eccentricOrange/can-daq/docs/system-diagram/system-diagram-transparent.drawio.png

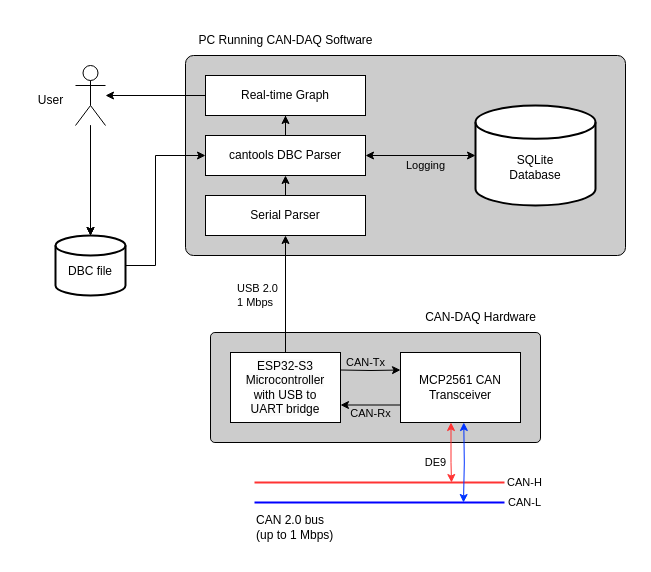
docs/system-diagram/system-diagram-transparent.drawio.png
