eccentricOrange/can-daq/can-daq-pcb/can-daq-pcb.kicad_pcb

## KiCad design can-daq-pcb/can-daq-pcb.kicad_pcb (2025-04-13)

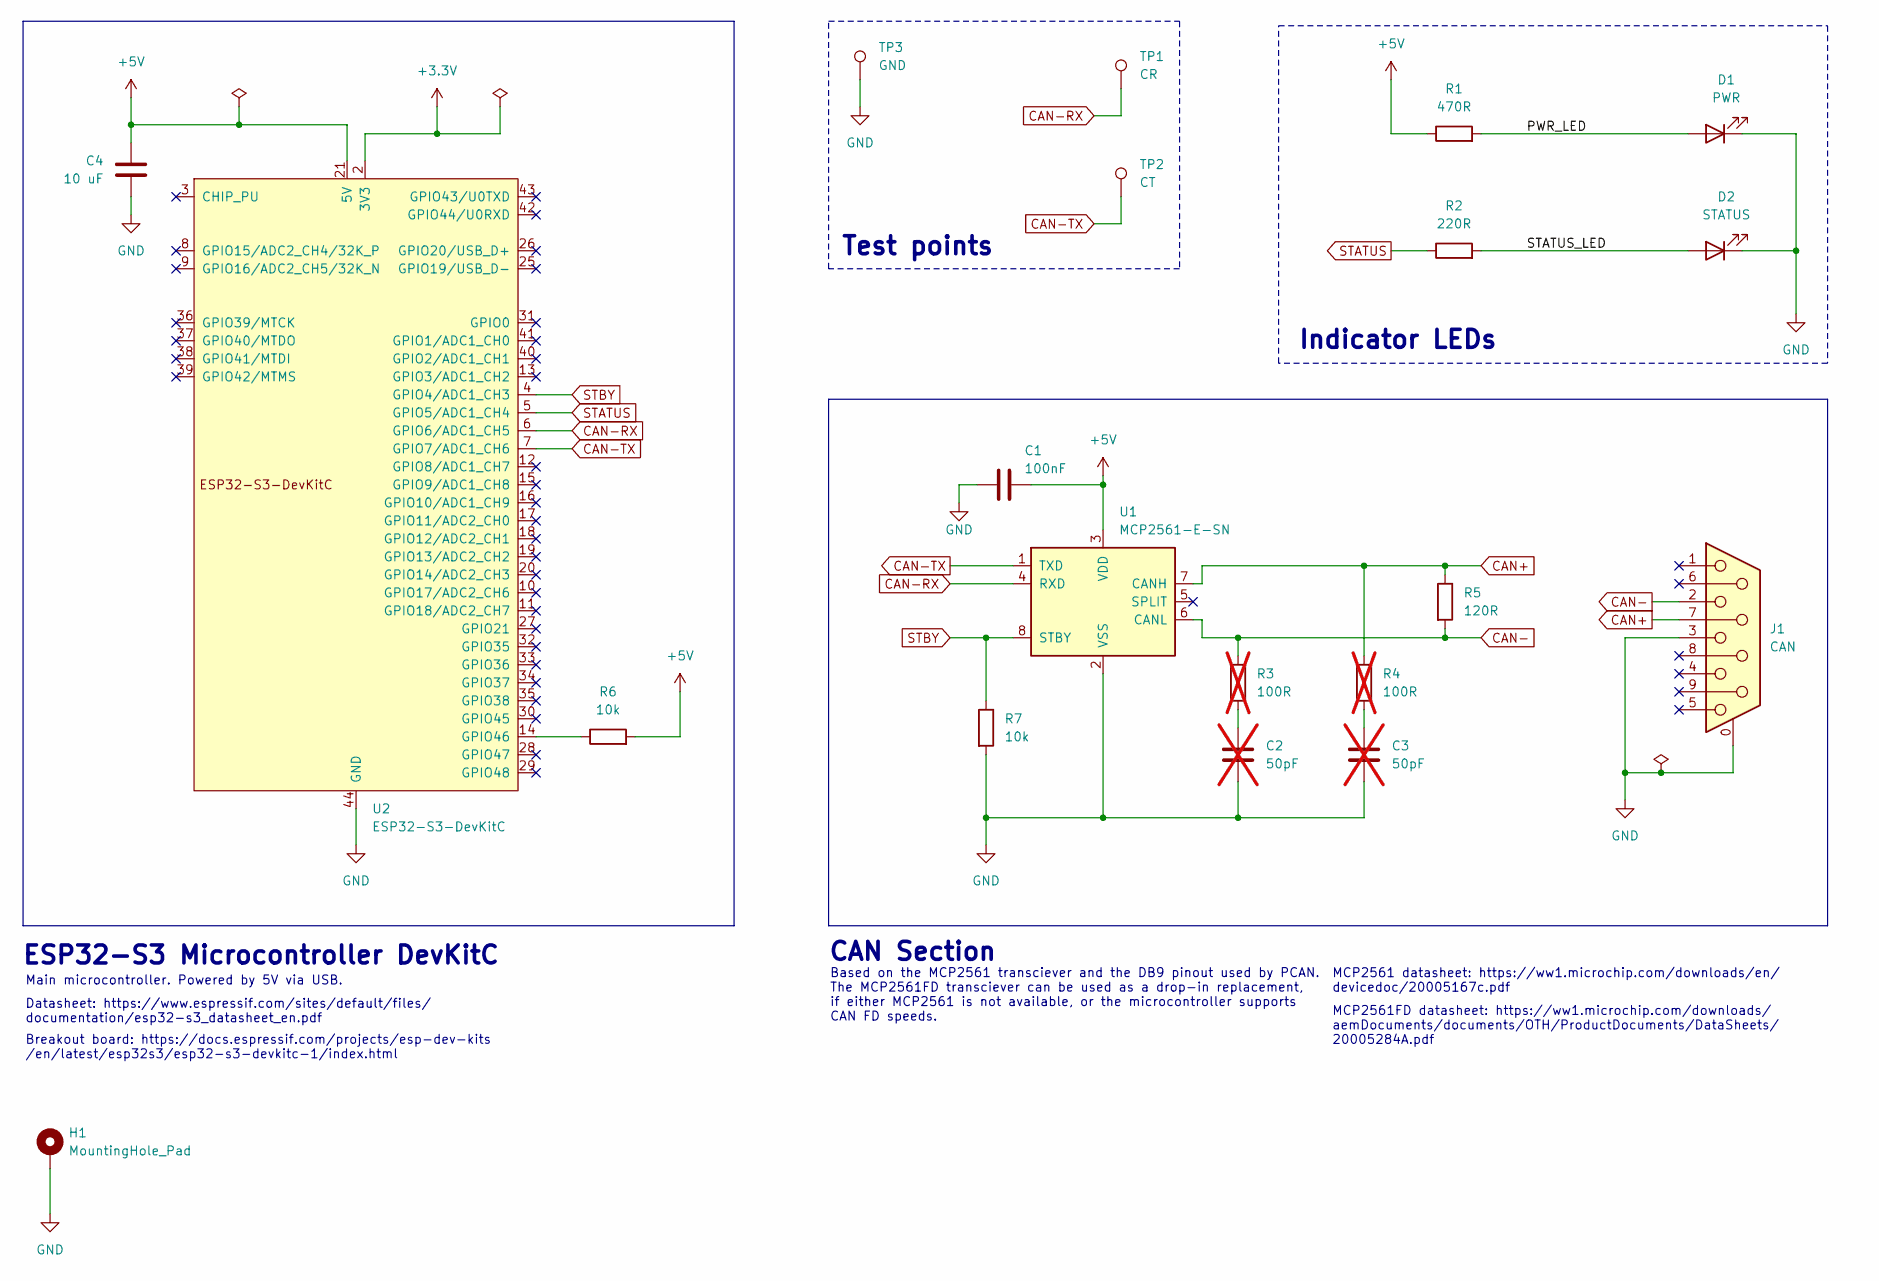
[picture p11: schematic can-daq-pcb.kicad_sch, CAN-DAQ PCB]

Parts:
C1: 100nF; C_0805_2012Metric_Pad1.18x1.45mm_HandSolder; MPN CC0805KRX7R9BB104; JLC C49678
C2, C3: 50pF; C_1206_3216Metric_Pad1.33x1.80mm_HandSolder; MPN FCC1206N470J102DT; JLC C5137553; not fitted
C4: 10 uF; C_1206_3216Metric_Pad1.33x1.80mm_HandSolder; MPN CL31A106KBHNNNE; JLC C13585
D1: PWR; LED_D3.0mm; MPN TZ-L2-03YYBR2RDJ30-003; JLC C779429
D2: STATUS; LED_D3.0mm; MPN TJ-L3FYTGCBMCGSFLC6B-A5; JLC C330760
H1: MountingHole_Pad; MountingHole_3.2mm_M3_Pad_Via
J1: CAN; DSUB-9_Female_Horizontal_P2.77x2.84mm_EdgePinOffset4.94mm_H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; MPN DS1037-09FNAKT74-0CC; JLC C75749
R1: 470R; R_1206_3216Metric_Pad1.30x1.75mm_HandSolder; MPN RC1206FR-07470RL; JLC C114945
R2: 220R; R_1206_3216Metric_Pad1.30x1.75mm_HandSolder; MPN 1206W4J0221T5E; JLC C25363
R3, R4: 100R; R_1206_3216Metric_Pad1.30x1.75mm_HandSolder; MPN 1206W4F1000T5E; JLC C17901; not fitted
R5: 120R; R_1206_3216Metric_Pad1.30x1.75mm_HandSolder; MPN 1206W4F1200T5E; JLC C17909
R6, R7: 10k; R_1206_3216Metric_Pad1.30x1.75mm_HandSolder; MPN 1206W4F1002T5E; JLC C17902
TP1: CR; TestPoint_THTPad_1.0x1.0mm_Drill0.5mm
TP2: CT; TestPoint_THTPad_1.0x1.0mm_Drill0.5mm
TP3: GND; TestPoint_THTPad_1.0x1.0mm_Drill0.5mm
U1: MCP2561-E-SN; SOIC-8_3.9x4.9mm_P1.27mm; MPN MCP2561-E/SN; JLC C219833
U2: ESP32-S3-DevKitC; MPN ESP32-S3-DEVKITC-1-N8; JLC C20438410

Connections:
+3.3V: U2.1 (3V3), U2.2 (3V3)
+5V: C1.1, C4.1, R1.1, R6.2, U1.3 (VDD), U2.21 (5V)
/PWR_LED: D1.2 (A), R1.2
/STATUS_LED: D2.2 (A), R2.2
CAN+: J1.7, R4.1, R5.1, U1.7 (CANH)
CAN-: J1.2, R3.1, R5.2, U1.6 (CANL)
CAN-RX: TP1.1, U1.4 (RXD), U2.6 (GPIO6/ADC1_CH5)
CAN-TX: TP2.1, U1.1 (TXD), U2.7 (GPIO7/ADC1_CH6)
GND: C1.2, C2.2, C3.2, C4.2, D1.1 (K), D2.1 (K), H1.1, J1.0 (PAD), J1.3, R7.2, TP3.1, U1.2 (VSS), U2.22 (GND), U2.23 (GND), U2.24 (GND), U2.44 (GND)
unnamed: C2.1, R3.2
unnamed: C3.1, R4.2
unnamed: R6.1, U2.14 (GPIO46)
STATUS: R2.1, U2.5 (GPIO5/ADC1_CH4)
STBY: R7.1, U1.8 (STBY), U2.4 (GPIO4/ADC1_CH3)

Notes on the sheet:
Main microcontroller. Powered by 5V via USB.
Based on the MCP2561 transciever and the DB9 pinout used by PCAN. The MCP2561FD transciever can be used as a drop-in replacement, if either MCP2561 is not available, or the microcontroller supports CAN FD speeds.
CAN Section
Indicator LEDs
Datasheet: https://www.espressif.com/sites/default/files/ documentation/esp32-s3_datasheet_en.pdf
Breakout board: https://docs.espressif.com/projects/esp-dev-kits /en/latest/esp32s3/esp32-s3-devkitc-1/index.html
MCP2561 datasheet: https://ww1.microchip.com/downloads/en/ devicedoc/20005167c.pdf
MCP2561FD datasheet: https://ww1.microchip.com/downloads/ aemDocuments/documents/OTH/ProductDocuments/DataSheets/ 20005284A.pdf
ESP32-S3 Microcontroller DevKitC
Test points

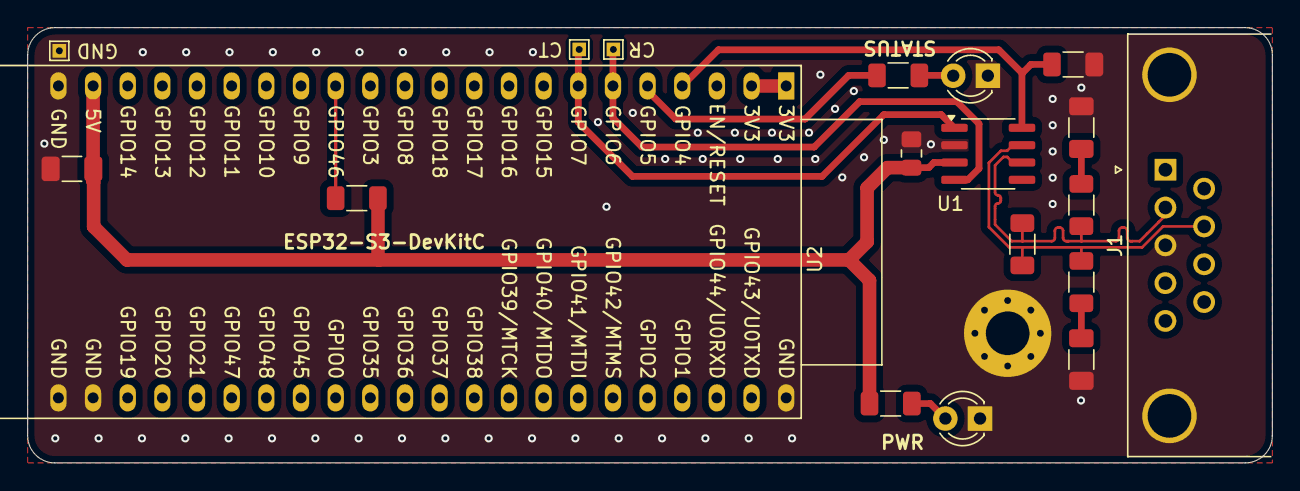
[picture p12: board can-daq-pcb.kicad_pcb from above]

Board: 2 copper layers, 91.2 x 31.9 mm, 20 parts (0 on the bottom side), 14 nets.
